laphysiqueaveclesmains/Covid-19-CO2/README.md

# Covid-19-CO2
The files associated with the open source CO2 monitoring device designed by Pierre Carles for Sorbonne Universite.

You will find here a detailed tutorial for building and using your own version of the present CO2 monitoring device, along with the source Arduino code that drives the microcontroler.
